pmalagon/ISPR2020/Hardware/Simulaciones/Montecarlo.asc

C1: cap; {mc(1n,tolc)}
C2: cap; {mc(1n,tolc)}
C3: cap; {mc(82p,tolc)}
C4: cap; {mc(100p,tolc)}
R1: res; {mc(6.2k,tolr)}; tol=1
R2: res; {mc(180k,tolr)}; tol=1
R3: res; {mc(27k,tolr)}; tol=1
R4: res; {mc(27k,tolr)}; tol=1
U1: ADA4661-2
U2: ADA4661-2
V1: voltage; SINE(0.575 0.25 440); AC 1
V2: voltage; 3.3
Named nets: 0, 3.3, E1, E2
;tran 0 0.01 0 0.001
.step param run 1 20 1
.param tolc=0.01 tolr=0.01
;noise V(E2) V1 dec 100 20 40k
.ac dec 100 10 1000000
.param pot_g_a=62k
.param pot_offset_a=360k
;step param pot_g_b 220 1220 100
;step param pot_g_a 31k 124k 15.5k
.param pot_g_b=720
.param pot_offset_b=410
;step param pot_offset_b 390 490 20
;step param pot_offset_a 180k 540k 90k
