pmalagon/ISPR2020/Hardware/Simulaciones/Simulaciones.asc

C1: cap; {mc(3.6n,tolc)}
C2: cap; {mc(5.6n,tolc)}
C3: cap; {mc(470p,tolc)}
C4: cap; {mc(360p,tolc)}
C5: cap; {mc(3u,tolc)}
R1: res; {mc(1.6k,tolr)}; tol=1
R2: res; {mc(47k,tolr)}; tol=1
R3: res; {mc(5.1k,tolr)}; tol=1
R4: res; {mc(5.1k,tolr)}; tol=1
R5: res; {mc(1.8k,tolr)}
R6: res; {mc(110k,tolr)}
R7: res; {mc(820,tolr)}
R8: res; {mc(pot_offset_b,0)}
R9: res; {mc(pot_g_b,0)}
R10: res; {mc(200k,tolr)}
R11: res; {mc(62k,tolr)}
R12: res; {mc(2k,tolr)}
R13: res; {mc(5.6k,tolr)}
R14: res; {mc(51k,tolr)}
R15: res; {mc(10k,tolr)}
U1: ADA4661-2
U2: ADA4661-2
U3: ADA4661-2
U4: ADA4661-2
V1: voltage; SINE(0.7 0.0003 440); AC 1
V2: voltage; 3.3
Named nets: 0, 3.3, E1, E2, HP, AMP
;tran 0 0.01 0 0.001
;step param run 1 20 1
.param tolc=0 tolr=0
.noise V(E2) V1 dec 100 20 40k
;ac dec 100 10 1000000
;step param pot_g_b 4000 5000 100
.param pot_g_b=4000
.param pot_offset_b=734
;step param pot_offset_b 700 800 20
