pmalagon/ISPR2020/Hardware/Simulaciones/WorstCases.asc

C1: cap; {mc(1n,tolc)}
C2: cap; {mc(1n,tolc)}
C3: cap; {mc(82p,tolc)}
C4: cap; {mc(100p,tolc)}
C5: cap; {mc(3u,tolc)}
R1: res; {mc(6.2k,tolr)}; tol=1
R2: res; {mc(180k,tolr)}; tol=1
R3: res; {mc(27k,tolr)}; tol=1
R4: res; {mc(27k,tolr)}; tol=1
R5: res; {wc(1.8k,tols,1)}
R6: res; {wc(110k,tols,0)}
R7: res; {mc(820,tolr)}
R8: res; {mc(pot_offset_b,0)}
R9: res; {mc(pot_g_b,0)}
R10: res; {mc(200k,tolr)}
R11: res; {wc(62k,tols,2)}
R12: res; {wc(2k,tols,3)}
U1: ADA4661-2
U2: ADA4661-2
U3: ADA4661-2
U4: ADA4661-2
V1: voltage; SINE(0.7 0.0003 440); AC 1
V2: voltage; 3.3
Named nets: 0, 3.3, E1, E2, HP, AMP
.tran 0 0.01 0 0.001
.noise V(E2) V1 dec 100 20 40k
;ac dec 100 10 1000000
;step param pot_g_b 3000 5000 200
.param pot_g_b=4000
.param pot_offset_b=734
;step param pot_offset_b 390 490 20
.func wc(nom,tol,index) if(run==numruns,nom,if(binary(run,index),nom*(1+tol),nom*(1-tol)))
.func binary(run,index) floor(run/(2**index))-2*floor(run/(2**(index+1)))
.param numruns=16
.step param run 1 16 1
.param tolc=0.01 tolr=0.01 tols=0.01
;param tolc=0 tolr=0 tols=0
.meas VoutAvg avg V(HP)
