pmalagon/ISPR2020/(list of files, drawings)

Other design files:
Hardware/ISPR_DEOP/Connector.SchDoc
Hardware/ISPR_DEOP/Filter.SchDoc
Hardware/ISPR_DEOP/ISPR_DEOP.PrjPcb
Hardware/ISPR_DEOP/Main.SchDoc
Hardware/ISPR_DEOP/Microfono.SchDoc
Hardware/ISPR_DEOP/PCB_Microfonos.PcbDoc
Hardware/ISPR_DEOP/Sheet1.SchDoc
Hardware/ISPR_DEOP_2/ConnectorPMOD.SchDoc
Hardware/ISPR_DEOP_2/ISPR_DEOP_2.PrjPcb
Hardware/PCBs version 1/PCB_conectores.PcbDoc
Hardware/PCBs version 1/PCB_Microfonos.PcbDoc
Hardware/PCBs version 2/ConnectorPMOD.PcbDoc
Hardware/PCBs version 2/PCB_Microfonos.PcbDoc
Hardware/PCBs version 3/PCB_conectores.PcbDoc
Hardware/PCBs version 3/PCB_Microfonos.PcbDoc
