pmalagon/ISPR2020/(commit log)

2020-03-30 Entrega de esquematicos v1.1
    [Connector.SchDoc, ConnectorPMOD.SchDoc, Filter.SchDoc, ISPR_DEOP.PrjPcb, ISPR_DEOP_2.PrjPcb, PCB_Microfonos.PcbDoc]
2020-03-31 Entrega Esquemativos V1.2
    [Connector.SchDoc, ConnectorPMOD.SchDoc, Filter.SchDoc, ISPR_DEOP.PrjPcb, ISPR_DEOP_2.PrjPcb, Microfono.SchDoc, PCB_Microfonos.PcbDoc]
2020-04-01 Esquematicos V1.3F
    [Connector.SchDoc, ConnectorPMOD.SchDoc, Filter.SchDoc, ISPR_DEOP.PrjPcb, ISPR_DEOP_2.PrjPcb, Microfono.SchDoc, PCB_Microfonos.PcbDoc]
2020-04-03 PCBs v1
    [PCB_Microfonos.PcbDoc, PCB_conectores.PcbDoc]
